cwichel/CCTVal_Steppers/Design documents/Pololu_Drivers.xlsx

 | AMIS-30543 page (https://www.pololu.com/product/2970/) | A4988 page (https://www.pololu.com/product/2980/) | A4988, Black Edition page (https://www.pololu.com/product/2976/) | DRV8880 page (https://www.pololu.com/product/2971/) | DRV8834 page (https://www.pololu.com/product/2134/) | DRV8824 page (https://www.pololu.com/product/2131/) | DRV8825 page (https://www.pololu.com/product/2977/)
Modelo | AMIS-30543 | A4988 | A4988, Black Edition | DRV8880 | DRV8834, Low-Voltage | DRV8824, Low-Current | DRV8825, High-Current
Imagen referencial
Minimum operating voltage (VM, VMOT) [V] | 6 | 8 | 8 | 2017-05-06 | 2017-05-02 | 2017-02-08 | 2017-02-08
Maximum operating voltage (VM, VMOT) [V] | 30 | 35 | 35 | 45 | 2017-08-10 | 45 | 45
Minimum logic voltage (VDD) [V] | 2017-05-02 | 3 | 3 | 2017-08-01 | 2017-05-02 | 2017-05-02 | 2017-05-02
Maximum logic voltage (VDD) [V] | 2017-05-05 | 2017-05-05 | 2017-05-05 | 2017-03-05 | 2017-05-05 | 5.25 | 5.25
Continuous current per phase [A] | 2017-08-01 | 1 | 2017-02-01 | 1 | 2017-05-01 | 0.75 | 2017-05-01
Maximum current per phase[A] with cooling | 3 | 2 | 2 | 2017-06-01 | 2 | 2017-02-01 | 2017-02-02
Microstep resolutions | full 1/2 1/4 1/8 1/16 1/32 1/64 1/128 | full 1/2 1/4 1/8 1/16 - - - | full 1/2 1/4 1/8 1/16 - - - | full 1/2, 1/2 non-circular 1/4 1/8 1/16 - - - | full 1/2 1/4 1/8 1/16 1/32 - - | full 1/2 1/4 1/8 1/16 1/32 - - | full 1/2 1/4 1/8 1/16 1/32 - -
 | limited current for VMOT<5V |  |  | It does not take external VDD supply | It does not take external VDD supply | It does not take external VDD supply | It does not take external VDD supply
