cwichel/CCTVal_Steppers/Design documents/Comm_Model.png

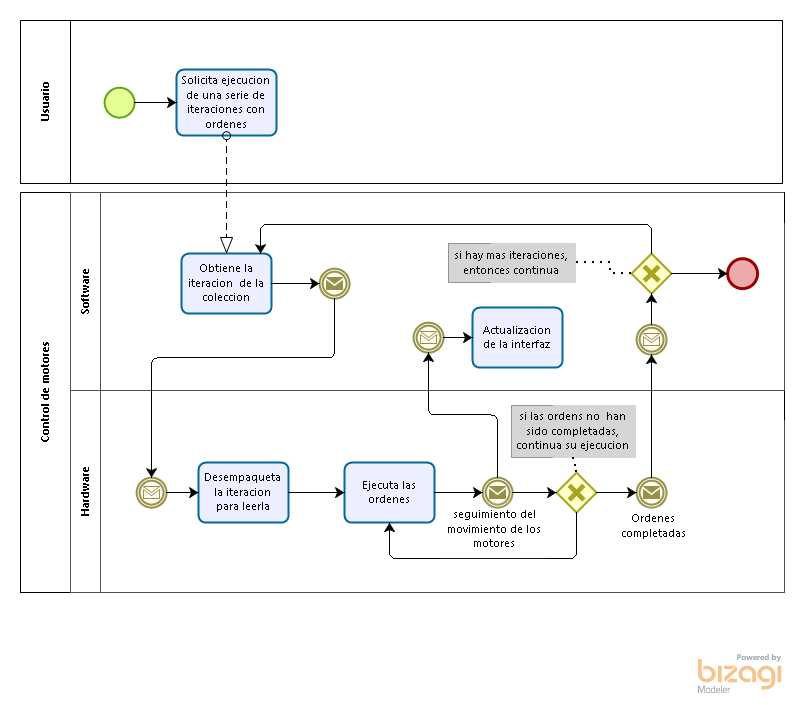
Design documents/Comm_Model.png
