cwichel/CCTVal_Steppers/Design documents/GUI.png

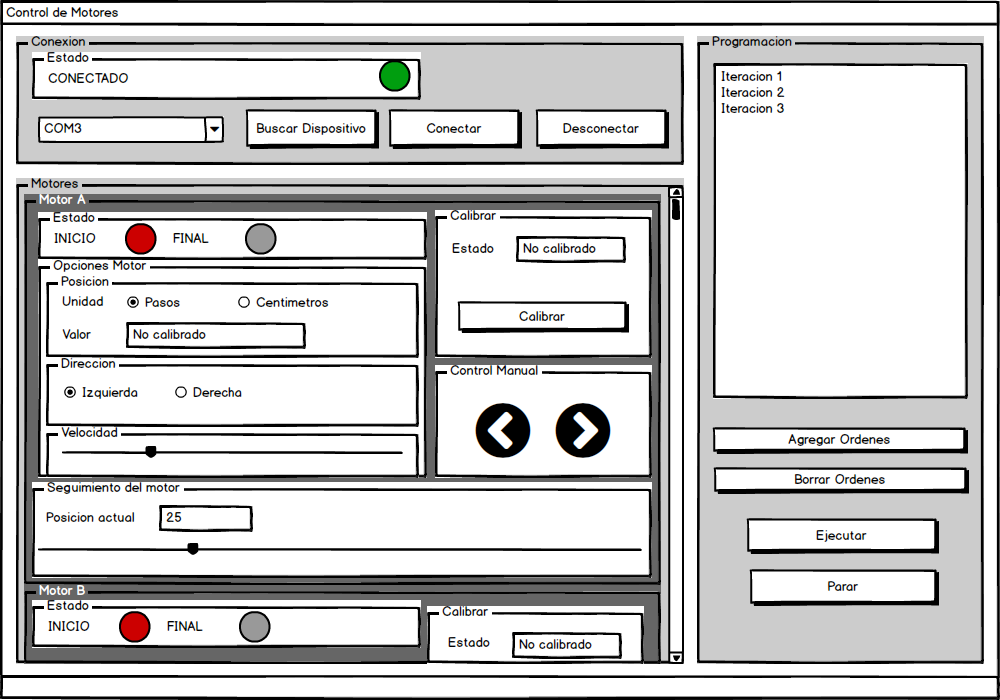
Design documents/GUI.png
