cwichel/CCTVal_Steppers/BOM/Steppers V2_0/BOM_Aliexpress_CCTVAL.csv

//Quantity | Company | Product | Page
35 | Tenstar Store | Arduino DUE R3 | https://goo.gl/kFpVzn
1 | Awesome Home Appliance Store | Desatornillador electrónica (pequeña) | https://goo.gl/UByTF8
1 | Awesome Home Appliance Store | Desatornillador de presición | https://goo.gl/uQCTkJ
1 | Awesome Home Appliance Store | Desatornillador multipropósito | https://goo.gl/f14CaZ
1 | Shenzen Tool Top Store | Kit cableado de redes | https://goo.gl/8skEQ2
1 | Shenzhen electronic tools | Estación de soldado (china+with kit E) | https://goo.gl/YdAr94
1 | Cleqee store | Generador de señales | https://goo.gl/MJtyGm
1 | Cleqee store | Osciloscopio | https://goo.gl/vScLHC
2 | China Inverter Factory | Fuente DC ajustable | https://goo.gl/KiWFQX
