cwichel/CCTVal_Steppers/Design documents/Comm_Protocols.xlsx

Sheet: Comandos
Comandos PC → Arduino |  |  |  |  |  | Comandos Arduino → PC
Codigo |  |  |  |  |  | Codigo
Int | Byte | Ascii | Sigla | Descripción | Modo de uso | Int | Byte | Ascii | Sigla | Descripción | Modo de uso
Inicio y final de los códigos
60 | 3C | < | Start | Inicio de comando | Start Comando <parametros> End Exe | 70 | 46 | F | Sok | Start Final | Sok Comando <parametros> Fok Nxt
61 | 3D | = | End | Fin de comando |  | 71 | 47 | G | Fok | Start End
62 | 3E | > | Exe | Ejecutar comandos |  | 72 | 48 | H | Nxt | Ok to send next
Asociados a movimiento
80 | 50 | P | M | Movimiento libre | Start M <motorx1><dir><vel> End | 90 | 5A | Z | Fm | Movement finished, tells to software the actual position of the motors | Sok Fm <motorx1><#pos>… Fok
81 | 51 | Q | MR | Movimiento rápido | Start MR <#motor><motorx1><#pos><#vel>… End
82 | 52 | R | ML | Movimiento lineal | Start ML <#motor><motorx1><#pos>….<#vel> End
Asociados a configuración
100 | 64 | d | Cal | Calibración | Start Cal <#motor><motorx1>… End | 110 | 6E | n | Fcal | Calibration result msg | Sok Fcal <motorx1><#totalsteps>… Fok
101 | 65 | e | Set | Setea PPR | Start M <motorx1><dir><vel> End | 111 | 6F | o | ESUon | Motor llego a FC1 | Sok ESUon <motorx1> Fok
 |  |  |  |  |  | 112 | 70 | p | ESUoff | Motor salio de FC1 | Sok ESUoff <motorx1> Fok
 |  |  |  |  |  | 113 | 71 | q | ESLon | Motor llego a FC2 | Sok ESLon <motorx1> Fok
 |  |  |  |  |  | 114 | 72 | r | ESLoff | Motor salio de FC2 | Sok ESLoff <motorx1> Fok
Ejemplos

Sheet: Variables (para comandos)
Variable | tipo | bytes
Selección de motor | uint | 1
Dirección de giro | uint | 1
Indicación de velocidad (en rpm) | uint | 2
Cantidad de pasos en tramo (calibración) | uint | 4
Indicación de posición (en pasos) | uint | 4

Sheet: Otros
Var | Cantidad |  | Descripción |  | [us] | [Hz]
TInt | 2.5e-05 | [s] | Período de interrupción |  | 25 | 40000
Kchk | 0.03 | [s] | Periodo para check key |  | 30000 |  | 1200
PPV | 200 | [#] | Pasos por vuelta |  | [ipc] |  |  | [comprobacion]
V | 180 | [rpm] | Velocidad | -> | 33 |  |  | 181.8181818
 |  |  |  |  | 100 | 0.0025 | 400
