cwichel/CCTVal_Steppers/BOM/Steppers V2_0/BOM_Aliexpress.png

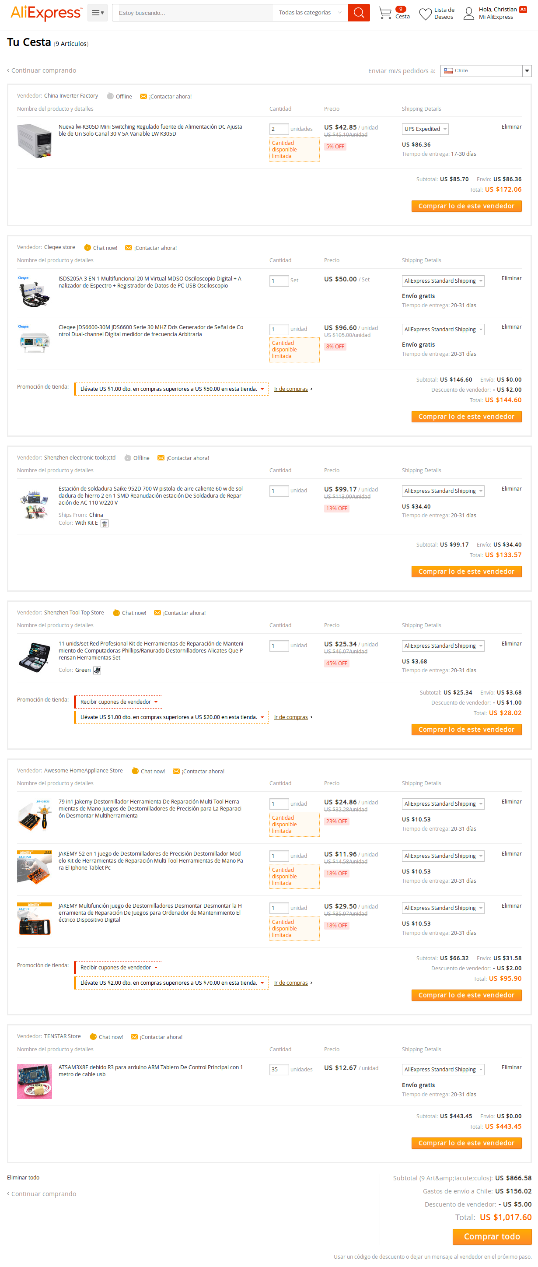
BOM/Steppers V2_0/BOM_Aliexpress.png
