cwichel/CCTVal_Steppers/BOM/Steppers V2_0/BOM_Digikey.png

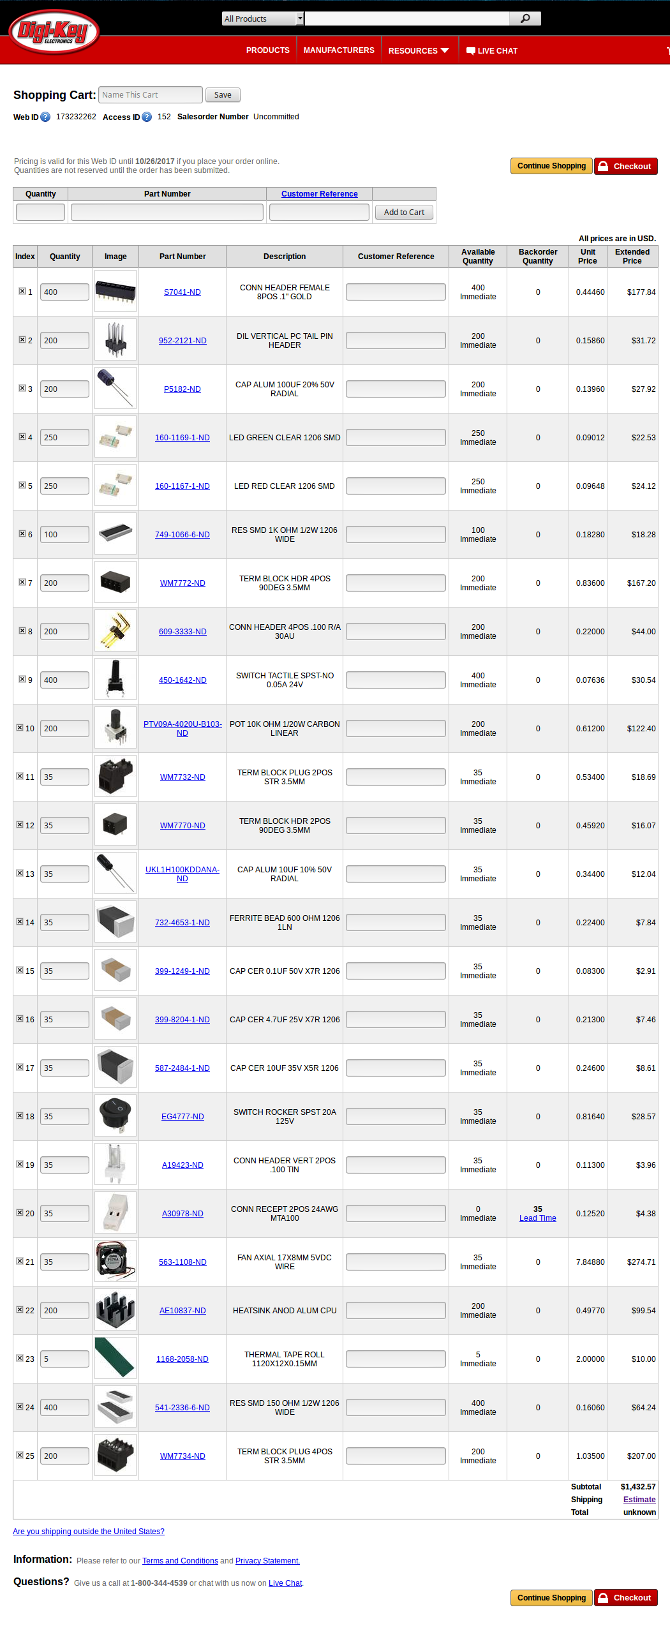
BOM/Steppers V2_0/BOM_Digikey.png
