cwichel/CCTVal_Steppers/BOM/Steppers V2_0/BOM_Mouser.png

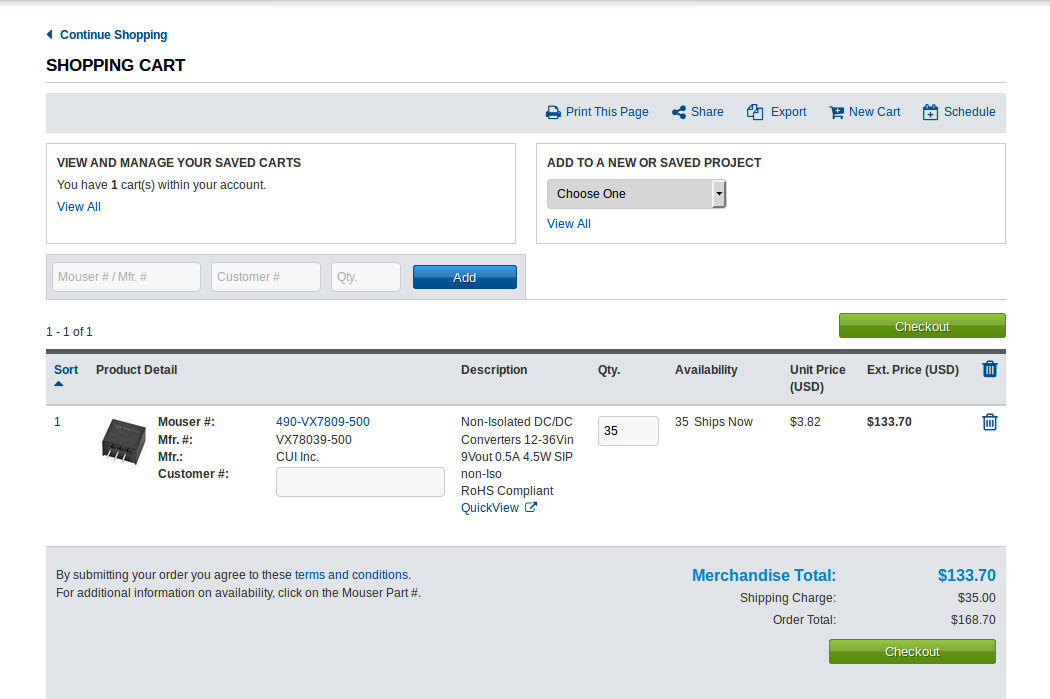
BOM/Steppers V2_0/BOM_Mouser.png
