cwichel/CCTVal_Steppers/BOM/Steppers V2_0/BOM_Pololu.png

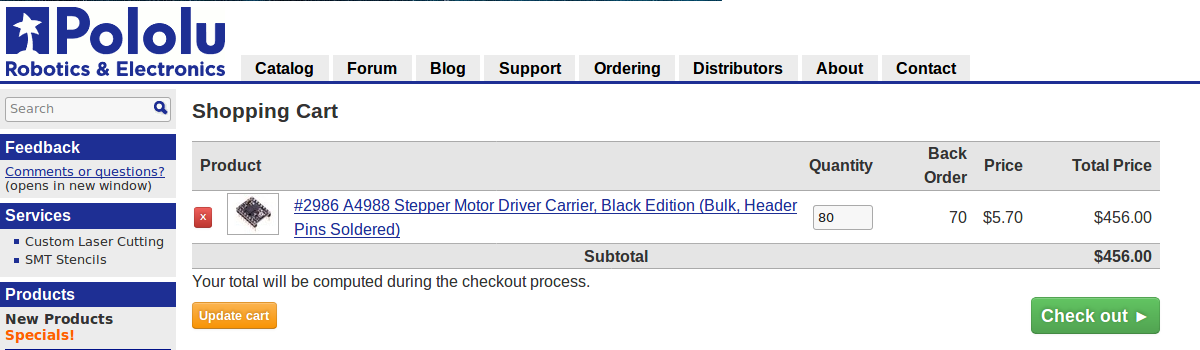
BOM/Steppers V2_0/BOM_Pololu.png
