cwichel/CCTVal_Steppers/BOM/Steppers V2_0/BOM_Seeed.png

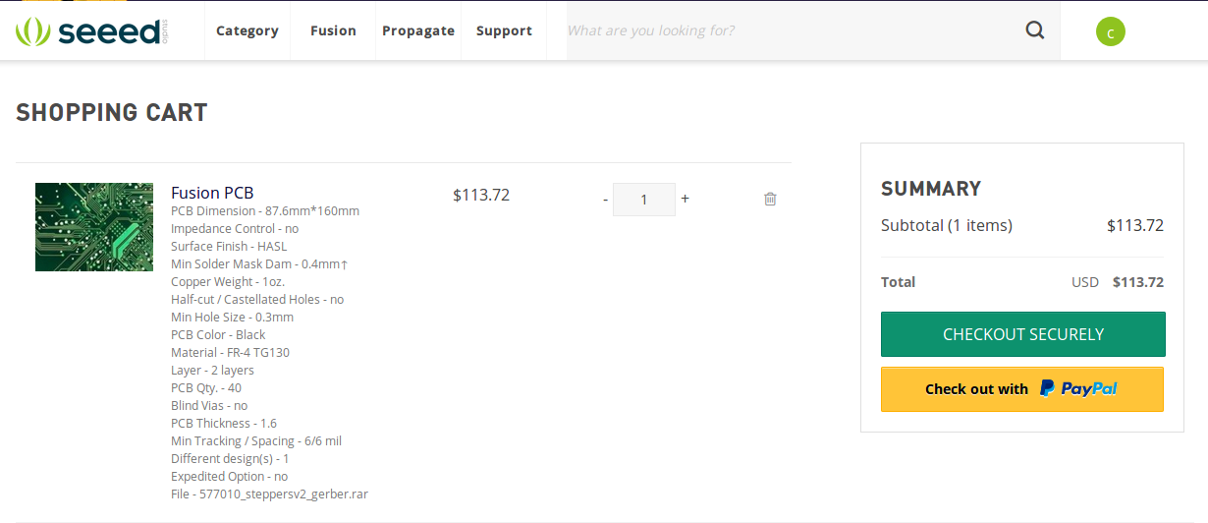
BOM/Steppers V2_0/BOM_Seeed.png
