cwichel/CCTVal_Steppers/CAD/Stepper_1_0/Stepper_1_0.brd

## EAGLE design CAD/Stepper_1_0/Stepper_1_0.brd (2017-09-14)

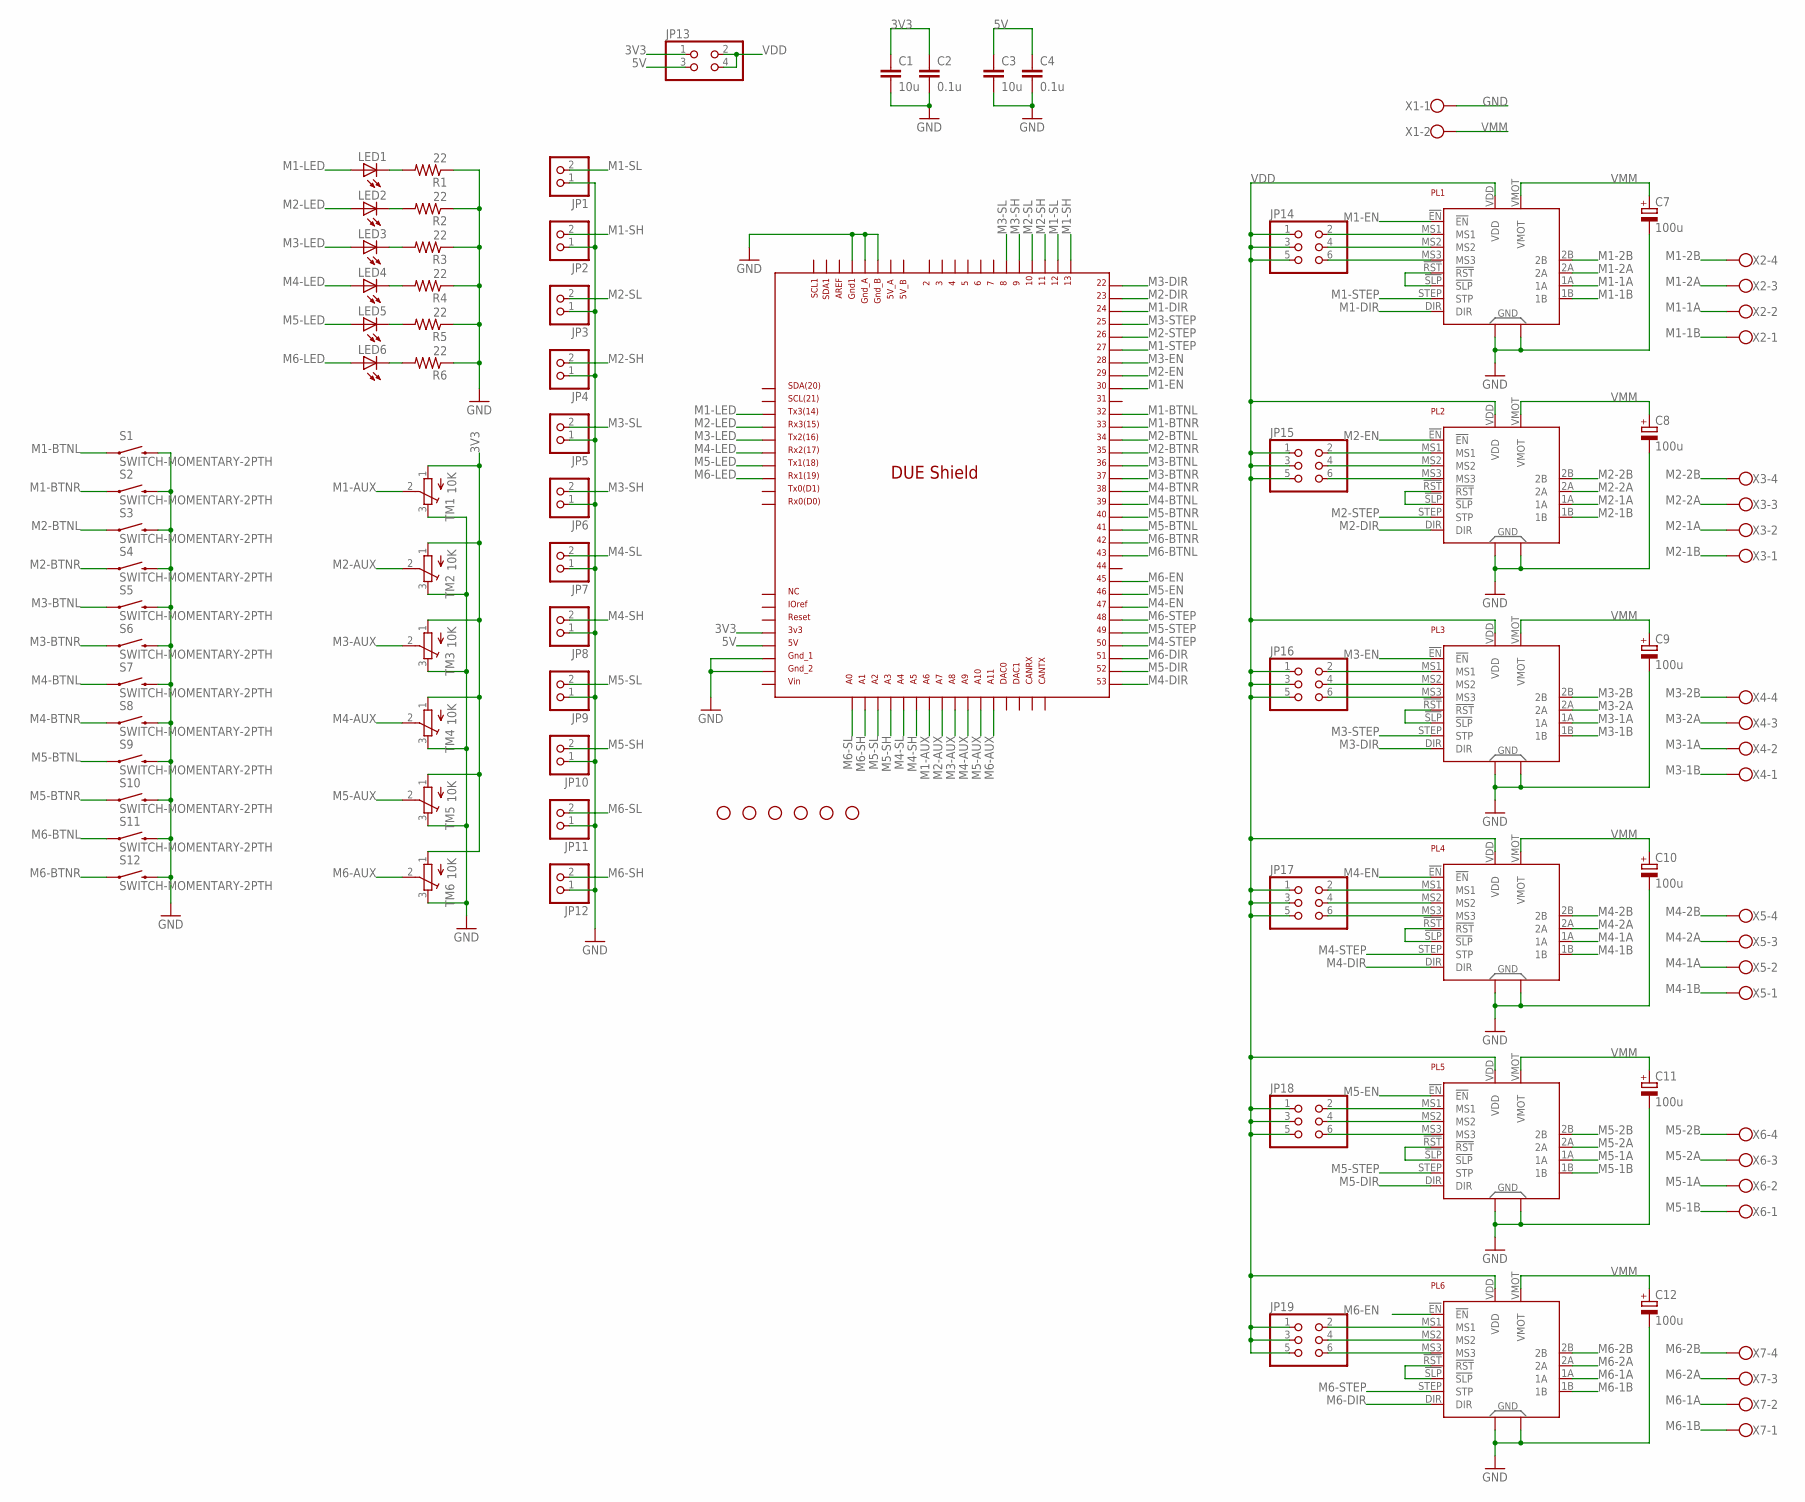
[picture p8: schematic Stepper_1_0.sch]

Parts:
C1, C3: 10u; 1206
C2, C4: 0.1u; 1206
C7, C8, C9, C10, C11, C12: 100u; ETR2
H1, H2, H3, H4, H5, H6: STAND-OFF
JP1, JP2, JP3, JP4, JP5, JP6, JP7, JP8, JP9, JP10, JP11, JP12: PINHD-1X2; 1X02
JP13: PINHD-2X2; 2X02
JP14, JP15, JP16, JP17, JP18, JP19: PINHD-2X3; 2X03
LED1, LED2, LED3, LED4, LED5, LED6: LEDSMT1206; 1206
PL1, PL2, PL3, PL4, PL5, PL6: A4988X; MD09X
R1, R2, R3, R4, R5, R6: 22; 1206
S1, S2, S3, S4, S5, S6, S7, S8, S9, S10, S11, S12: SWITCH-MOMENTARY-2PTH; TACTILE-PTH
SH1: DUE(NOSPI)
TM1, TM2, TM3, TM4, TM5, TM6: 10K; TC33X
X1: W237-102
X2, X3, X4, X5, X6, X7: W237-4

Connections:
3V3: C1.1, C2.1, JP13.1, SH1.3V3, TM1.1 (A), TM2.1 (A), TM3.1 (A), TM4.1 (A), TM5.1 (A), TM6.1 (A)
5V: C3.1, C4.1, JP13.3, SH1.5V
GND: C1.2, C2.2, C3.2, C4.2, C7.-, C8.-, C9.-, C10.-, C11.-, C12.-, JP1.1, JP2.1, JP3.1, JP4.1, JP5.1, JP6.1, JP7.1, JP8.1, JP9.1, JP10.1, JP11.1, JP12.1, PL1.GND1, PL1.GND2, PL2.GND1, PL2.GND2, PL3.GND1, PL3.GND2, PL4.GND1, PL4.GND2, PL5.GND1, PL5.GND2, PL6.GND1, PL6.GND2, R1.1, R2.1, R3.1, R4.1, R5.1, R6.1, S1.3 (2), S2.3 (2), S3.3 (2), S4.3 (2), S5.3 (2), S6.3 (2), S7.3 (2), S8.3 (2), S9.3 (2), S10.3 (2), S11.3 (2), S12.3 (2), SH1.GND1, SH1.GND_1, SH1.GND_2, SH1.GND_A, SH1.GND_B, TM1.3 (E), TM2.3 (E), TM3.3 (E), TM4.3 (E), TM5.3 (E), TM6.3 (E), X1.1
M1-1A: PL1.1A, X2.2
M1-1B: PL1.1B, X2.1
M1-2A: PL1.2A, X2.3
M1-2B: PL1.2B, X2.4
M1-AUX: SH1.A6, TM1.2 (S)
M1-BTNL: S1.1, SH1.32
M1-BTNR: S2.1, SH1.33
M1-DIR: PL1.DIR, SH1.24
M1-EN: PL1.!EN, SH1.30
M1-LED: LED1.A, SH1.TX3
M1-SH: JP2.2, SH1.13
M1-SL: JP1.2, SH1.12
M1-STEP: PL1.STEP (STP), SH1.27
M2-1A: PL2.1A, X3.2
M2-1B: PL2.1B, X3.1
M2-2A: PL2.2A, X3.3
M2-2B: PL2.2B, X3.4
M2-AUX: SH1.A7, TM2.2 (S)
M2-BTNL: S3.1, SH1.34
M2-BTNR: S4.1, SH1.35
M2-DIR: PL2.DIR, SH1.23
M2-EN: PL2.!EN, SH1.29
M2-LED: LED2.A, SH1.RX3
M2-SH: JP4.2, SH1.11
M2-SL: JP3.2, SH1.10
M2-STEP: PL2.STEP (STP), SH1.26
M3-1A: PL3.1A, X4.2
M3-1B: PL3.1B, X4.1
M3-2A: PL3.2A, X4.3
M3-2B: PL3.2B, X4.4
M3-AUX: SH1.A8, TM3.2 (S)
M3-BTNL: S5.1, SH1.36
M3-BTNR: S6.1, SH1.37
M3-DIR: PL3.DIR, SH1.22
M3-EN: PL3.!EN, SH1.28
M3-LED: LED3.A, SH1.TX2
M3-SH: JP6.2, SH1.9
M3-SL: JP5.2, SH1.8
M3-STEP: PL3.STEP (STP), SH1.25
M4-1A: PL4.1A, X5.2
M4-1B: PL4.1B, X5.1
M4-2A: PL4.2A, X5.3
M4-2B: PL4.2B, X5.4
M4-AUX: SH1.A9, TM4.2 (S)
M4-BTNL: S7.1, SH1.39
M4-BTNR: S8.1, SH1.38
M4-DIR: PL4.DIR, SH1.53
M4-EN: PL4.!EN, SH1.47
M4-LED: LED4.A, SH1.RX2
M4-SH: JP8.2, SH1.A5
M4-SL: JP7.2, SH1.A4
M4-STEP: PL4.STEP (STP), SH1.50
M5-1A: PL5.1A, X6.2
M5-1B: PL5.1B, X6.1
M5-2A: PL5.2A, X6.3
M5-2B: PL5.2B, X6.4
M5-AUX: SH1.A10, TM5.2 (S)
M5-BTNL: S9.1, SH1.41
M5-BTNR: S10.1, SH1.40
M5-DIR: PL5.DIR, SH1.52
M5-EN: PL5.!EN, SH1.46
M5-LED: LED5.A, SH1.TX1
M5-SH: JP10.2, SH1.A3
M5-SL: JP9.2, SH1.A2
M5-STEP: PL5.STEP (STP), SH1.49
M6-1A: PL6.1A, X7.2
M6-1B: PL6.1B, X7.1
M6-2A: PL6.2A, X7.3
M6-2B: PL6.2B, X7.4
M6-AUX: SH1.A11, TM6.2 (S)
M6-BTNL: S11.1, SH1.43
M6-BTNR: S12.1, SH1.42
M6-DIR: PL6.DIR, SH1.51
M6-EN: PL6.!EN, SH1.45
M6-LED: LED6.A, SH1.RX1
M6-SH: JP12.2, SH1.A1
M6-SL: JP11.2, SH1.A0
M6-STEP: PL6.STEP (STP), SH1.48
unnamed: JP15.2, PL2.MS1
unnamed: PL1.!RST, PL1.!SLP
unnamed: JP15.6, PL2.MS3
unnamed: JP15.4, PL2.MS2
unnamed: PL2.!RST, PL2.!SLP
unnamed: PL3.!RST, PL3.!SLP
unnamed: JP16.6, PL3.MS3
unnamed: JP16.4, PL3.MS2
unnamed: PL4.!RST, PL4.!SLP
unnamed: JP14.6, PL1.MS3
unnamed: JP14.4, PL1.MS2
unnamed: JP14.2, PL1.MS1
unnamed: JP16.2, PL3.MS1
unnamed: JP17.6, PL4.MS3
unnamed: JP17.4, PL4.MS2
unnamed: JP17.2, PL4.MS1
unnamed: JP18.6, PL5.MS3
unnamed: JP18.4, PL5.MS2
unnamed: JP18.2, PL5.MS1
unnamed: JP19.6, PL6.MS3
unnamed: JP19.4, PL6.MS2
unnamed: JP19.2, PL6.MS1
unnamed: PL5.!RST, PL5.!SLP
unnamed: PL6.!RST, PL6.!SLP
unnamed: LED1.C, R1.2
unnamed: LED2.C, R2.2
unnamed: LED3.C, R3.2
unnamed: LED4.C, R4.2
unnamed: LED5.C, R5.2
unnamed: LED6.C, R6.2
VDD: JP13.2, JP13.4, JP14.1, JP14.3, JP14.5, JP15.1, JP15.3, JP15.5, JP16.1, JP16.3, JP16.5, JP17.1, JP17.3, JP17.5, JP18.1, JP18.3, JP18.5, JP19.1, JP19.3, JP19.5, PL1.VDD, PL2.VDD, PL3.VDD, PL4.VDD, PL5.VDD, PL6.VDD
VMM: C7.+, C8.+, C9.+, C10.+, C11.+, C12.+, PL1.VMOT, PL2.VMOT, PL3.VMOT, PL4.VMOT, PL5.VMOT, PL6.VMOT, X1.2

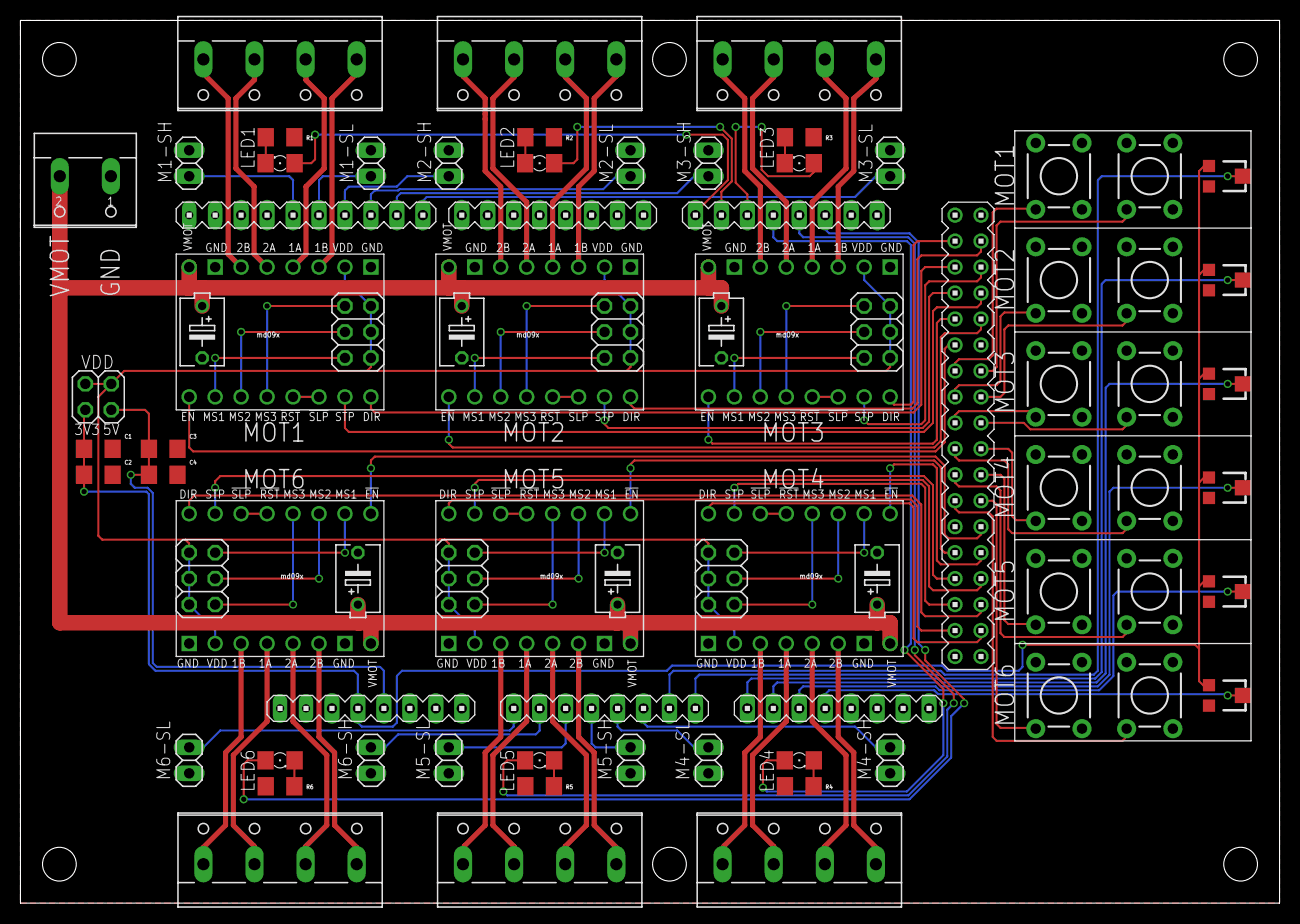
[picture p9: board Stepper_1_0.brd from above]

Board: 2 copper layers, 123.2 x 86.4 mm, 79 parts (0 on the bottom side), 113 nets.
