cwichel/CCTVal_Steppers/CAD/Stepper_2_0/Stepper_2_0.brd

## EAGLE design CAD/Stepper_2_0/Stepper_2_0.brd (2017-09-22)

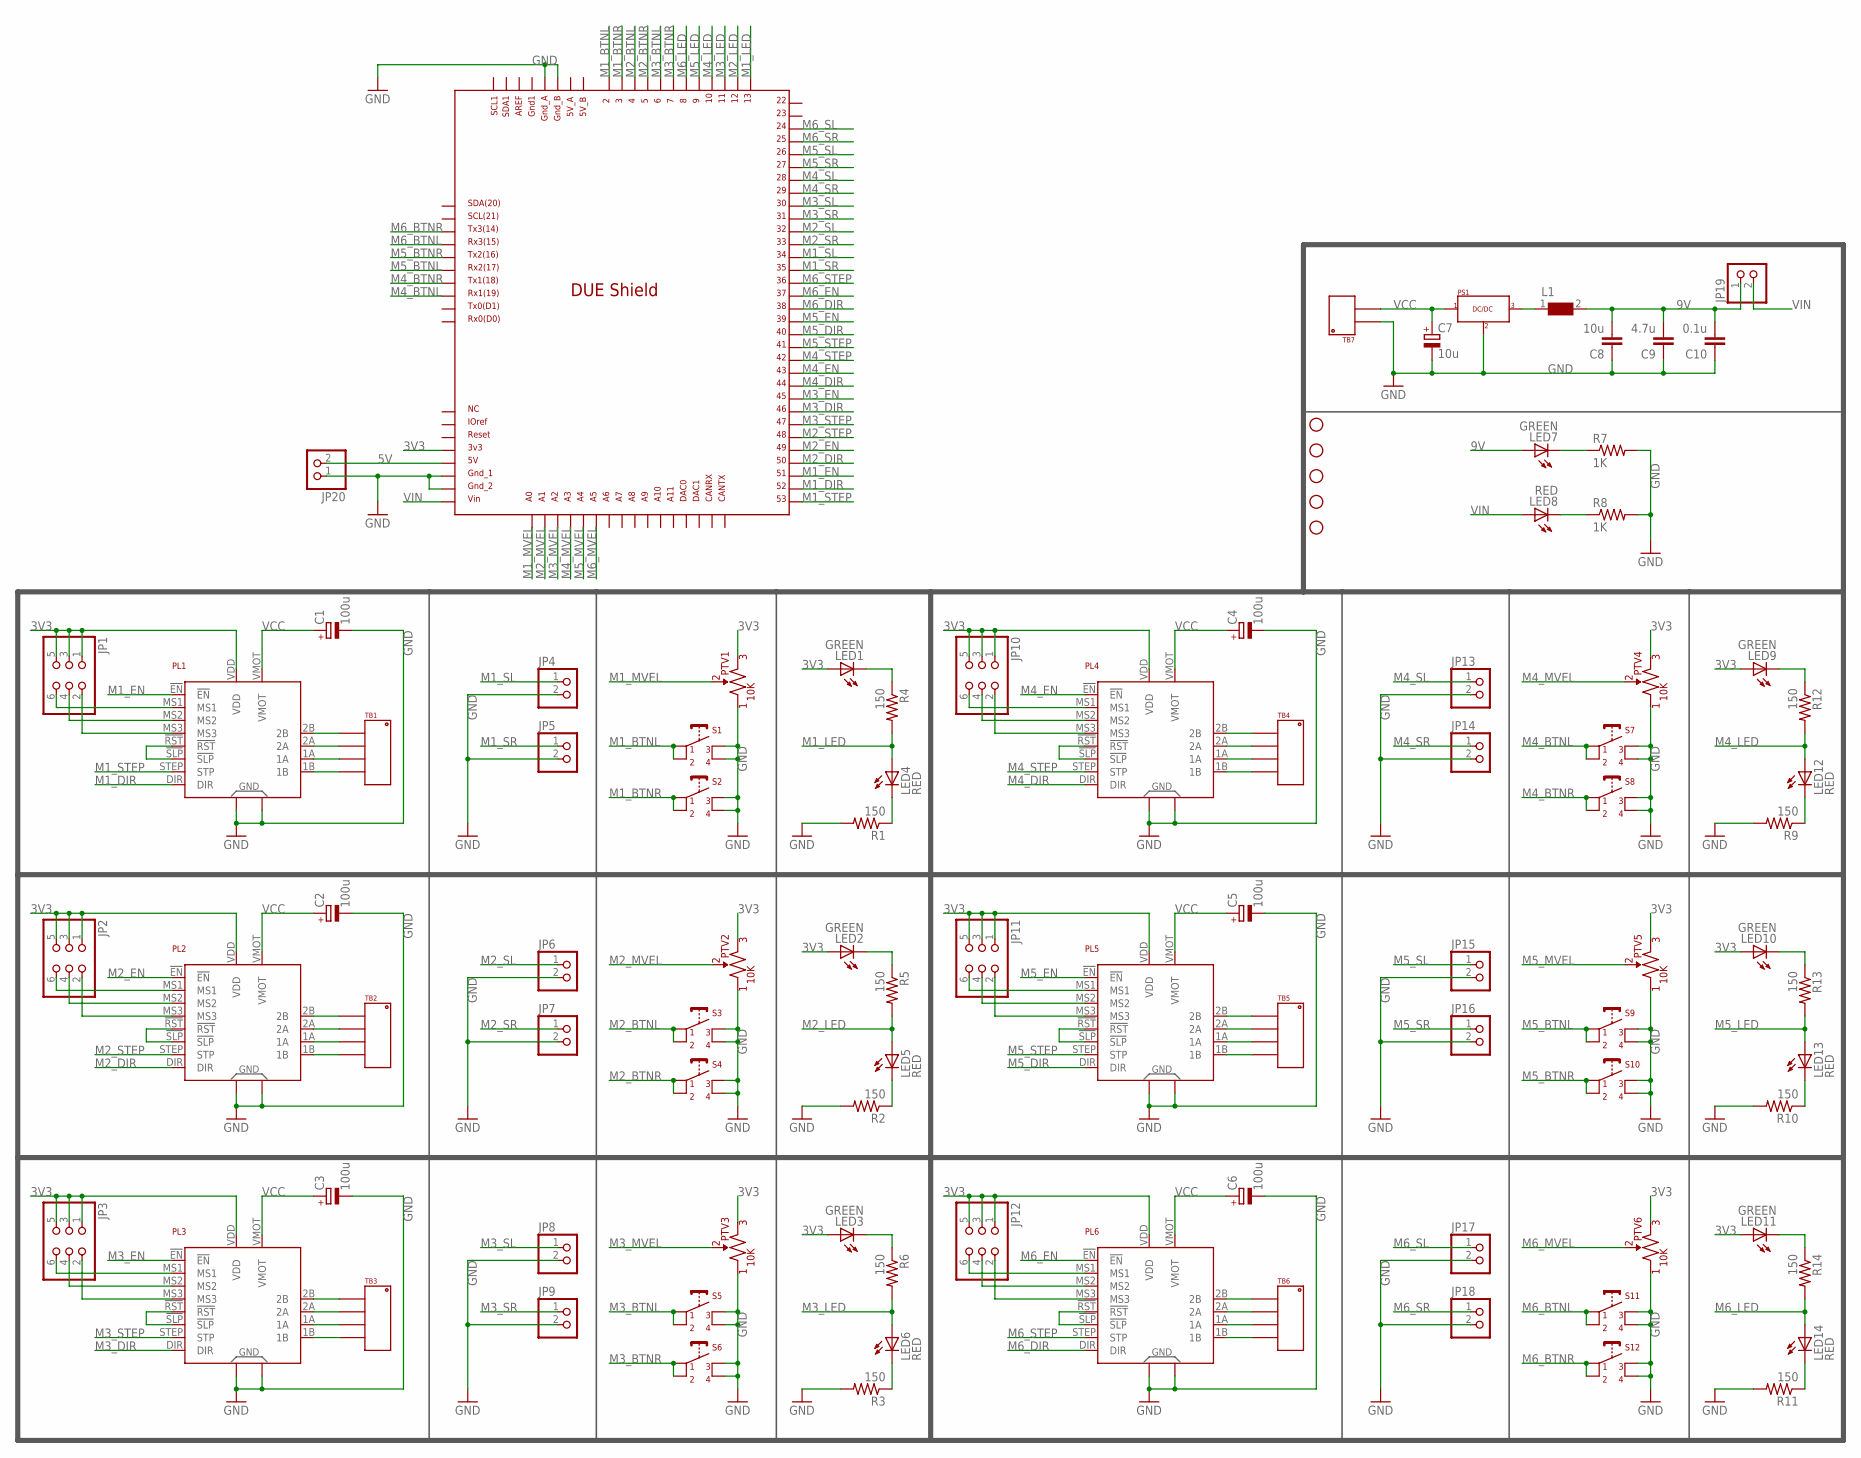
[picture p10: schematic Stepper_2_0.sch]

Parts:
C1, C2, C3, C4, C5, C6: 100u; ETR2
C7: 10u; E2-4
C8: 10u; 1206
C9: 4.7u; 1206
C10: 0.1u; 1206
DUE1: DUE(NOSPI)
H1, H2, H3, H4, H5: STAND-OFF
JP1, JP2, JP3, JP10, JP11, JP12: PINHD-2X3; 2X03
JP4, JP5, JP6, JP7, JP8, JP9, JP13, JP14, JP15, JP16, JP17, JP18, JP19, JP20: PINHD-1X2; 1X02
L1: WE-CBF-742792118_1206; 1206
LED1, LED2, LED3, LED7, LED9, LED10, LED11: GREEN; 1206
LED4, LED5, LED6, LED8, LED12, LED13, LED14: RED; 1206
PL1, PL2, PL3, PL4, PL5, PL6: A4988X; MD09X
PS1: VX78-500
PTV1, PTV2, PTV3, PTV4, PTV5, PTV6: 10K; PTV09A-4
R1, R2, R3, R4, R5, R6, R9, R10, R11, R12, R13, R14: 150; 1206
R7, R8: 1K; 1206
S1, S2, S3, S4, S5, S6, S7, S8, S9, S10, S11, S12: BTN_SPST_6MM
TB1, TB2, TB3, TB4, TB5, TB6: TB_HEAD_3.5MM_01X04
TB7: TB_HEAD_3.5MM_01X02

Connections:
3V3: DUE1.3V3, JP1.1, JP1.3, JP1.5, JP2.1, JP2.3, JP2.5, JP3.1, JP3.3, JP3.5, JP10.1, JP10.3, JP10.5, JP11.1, JP11.3, JP11.5, JP12.1, JP12.3, JP12.5, LED1.A, LED2.A, LED3.A, LED9.A, LED10.A, LED11.A, PL1.VDD, PL2.VDD, PL3.VDD, PL4.VDD, PL5.VDD, PL6.VDD, PTV1.P$3 (3), PTV2.P$3 (3), PTV3.P$3 (3), PTV4.P$3 (3), PTV5.P$3 (3), PTV6.P$3 (3)
5V: DUE1.5V, JP20.2
9V: C8.2, C9.2, C10.2, JP19.1, L1.2, LED7.A
GND: C1.-, C2.-, C3.-, C4.-, C5.-, C6.-, C7.-, C8.1, C9.1, C10.1, DUE1.GND_1, DUE1.GND_2, DUE1.GND_A, DUE1.GND_B, JP4.2, JP5.2, JP6.2, JP7.2, JP8.2, JP9.2, JP13.2, JP14.2, JP15.2, JP16.2, JP17.2, JP18.2, JP20.1, PL1.GND1, PL1.GND2, PL2.GND1, PL2.GND2, PL3.GND1, PL3.GND2, PL4.GND1, PL4.GND2, PL5.GND1, PL5.GND2, PL6.GND1, PL6.GND2, PS1.P$3, PTV1.P$1 (1), PTV2.P$1 (1), PTV3.P$1 (1), PTV4.P$1 (1), PTV5.P$1 (1), PTV6.P$1 (1), R1.2, R2.2, R3.2, R7.2, R8.2, R9.2, R10.2, R11.2, S1.P$3 (3), S1.P$4 (4), S2.P$3 (3), S2.P$4 (4), S3.P$3 (3), S3.P$4 (4), S4.P$3 (3), S4.P$4 (4), S5.P$3 (3), S5.P$4 (4), S6.P$3 (3), S6.P$4 (4), S7.P$3 (3), S7.P$4 (4), S8.P$3 (3), S8.P$4 (4), S9.P$3 (3), S9.P$4 (4), S10.P$3 (3), S10.P$4 (4), S11.P$3 (3), S11.P$4 (4), S12.P$3 (3), S12.P$4 (4), TB7.P$1
M1_BTNL: DUE1.2, S1.P$1 (1), S1.P$2 (2)
M1_BTNR: DUE1.3, S2.P$1 (1), S2.P$2 (2)
M1_DIR: DUE1.52, PL1.DIR
M1_EN: DUE1.51, PL1.!EN
M1_LED: DUE1.13, LED4.A, R4.2
M1_MVEL: DUE1.A0, PTV1.P$2 (2)
M1_SL: DUE1.34, JP4.1
M1_SR: DUE1.35, JP5.1
M1_STEP: DUE1.53, PL1.STEP (STP)
M2_BTNL: DUE1.4, S3.P$1 (1), S3.P$2 (2)
M2_BTNR: DUE1.5, S4.P$1 (1), S4.P$2 (2)
M2_DIR: DUE1.50, PL2.DIR
M2_EN: DUE1.49, PL2.!EN
M2_LED: DUE1.12, LED5.A, R5.2
M2_MVEL: DUE1.A1, PTV2.P$2 (2)
M2_SL: DUE1.32, JP6.1
M2_SR: DUE1.33, JP7.1
M2_STEP: DUE1.48, PL2.STEP (STP)
M3_BTNL: DUE1.6, S5.P$1 (1), S5.P$2 (2)
M3_BTNR: DUE1.7, S6.P$1 (1), S6.P$2 (2)
M3_DIR: DUE1.46, PL3.DIR
M3_EN: DUE1.45, PL3.!EN
M3_LED: DUE1.11, LED6.A, R6.2
M3_MVEL: DUE1.A2, PTV3.P$2 (2)
M3_SL: DUE1.30, JP8.1
M3_SR: DUE1.31, JP9.1
M3_STEP: DUE1.47, PL3.STEP (STP)
M4_BTNL: DUE1.RX1, S7.P$1 (1), S7.P$2 (2)
M4_BTNR: DUE1.TX1, S8.P$1 (1), S8.P$2 (2)
M4_DIR: DUE1.44, PL4.DIR
M4_EN: DUE1.43, PL4.!EN
M4_LED: DUE1.10, LED12.A, R12.2
M4_MVEL: DUE1.A3, PTV4.P$2 (2)
M4_SL: DUE1.28, JP13.1
M4_SR: DUE1.29, JP14.1
M4_STEP: DUE1.42, PL4.STEP (STP)
M5_BTNL: DUE1.RX2, S9.P$1 (1), S9.P$2 (2)
M5_BTNR: DUE1.TX2, S10.P$1 (1), S10.P$2 (2)
M5_DIR: DUE1.40, PL5.DIR
M5_EN: DUE1.39, PL5.!EN
M5_LED: DUE1.9, LED13.A, R13.2
M5_MVEL: DUE1.A4, PTV5.P$2 (2)
M5_SL: DUE1.26, JP15.1
M5_SR: DUE1.27, JP16.1
M5_STEP: DUE1.41, PL5.STEP (STP)
M6_BTNL: DUE1.RX3, S11.P$1 (1), S11.P$2 (2)
M6_BTNR: DUE1.TX3, S12.P$1 (1), S12.P$2 (2)
M6_DIR: DUE1.38, PL6.DIR
M6_EN: DUE1.37, PL6.!EN
M6_LED: DUE1.8, LED14.A, R14.2
M6_MVEL: DUE1.A5, PTV6.P$2 (2)
M6_SL: DUE1.24, JP17.1
M6_SR: DUE1.25, JP18.1
M6_STEP: DUE1.36, PL6.STEP (STP)
unnamed: PL2.1B, TB2.P$4
unnamed: PL2.1A, TB2.P$3
unnamed: PL2.2A, TB2.P$2
unnamed: PL2.2B, TB2.P$1
unnamed: PL2.!RST, PL2.!SLP
unnamed: JP2.2, PL2.MS3
unnamed: JP2.4, PL2.MS2
unnamed: JP2.6, PL2.MS1
unnamed: LED4.C, R1.1
unnamed: LED5.C, R2.1
unnamed: LED1.C, R4.1
unnamed: LED2.C, R5.1
unnamed: PL3.1B, TB3.P$4
unnamed: PL3.1A, TB3.P$3
unnamed: PL3.2A, TB3.P$2
unnamed: PL3.2B, TB3.P$1
unnamed: PL3.!RST, PL3.!SLP
unnamed: JP3.2, PL3.MS3
unnamed: JP3.4, PL3.MS2
unnamed: JP3.6, PL3.MS1
unnamed: LED6.C, R3.1
unnamed: LED3.C, R6.1
unnamed: PL4.1B, TB4.P$4
unnamed: PL4.1A, TB4.P$3
unnamed: PL4.2A, TB4.P$2
unnamed: PL4.2B, TB4.P$1
unnamed: PL4.!RST, PL4.!SLP
unnamed: JP10.2, PL4.MS3
unnamed: JP10.4, PL4.MS2
unnamed: JP10.6, PL4.MS1
unnamed: LED12.C, R9.1
unnamed: LED9.C, R12.1
unnamed: PL5.1B, TB5.P$4
unnamed: PL5.1A, TB5.P$3
unnamed: PL5.2A, TB5.P$2
unnamed: PL5.2B, TB5.P$1
unnamed: PL5.!RST, PL5.!SLP
unnamed: JP11.2, PL5.MS3
unnamed: JP11.4, PL5.MS2
unnamed: JP11.6, PL5.MS1
unnamed: LED13.C, R10.1
unnamed: LED10.C, R13.1
unnamed: PL6.1B, TB6.P$4
unnamed: PL6.1A, TB6.P$3
unnamed: PL6.2A, TB6.P$2
unnamed: PL6.2B, TB6.P$1
unnamed: PL6.!RST, PL6.!SLP
unnamed: JP12.6, PL6.MS1
unnamed: JP12.4, PL6.MS2
unnamed: JP12.2, PL6.MS3
unnamed: LED14.C, R11.1
unnamed: PL1.1B, TB1.P$4
unnamed: PL1.1A, TB1.P$3
unnamed: PL1.2A, TB1.P$2
unnamed: PL1.2B, TB1.P$1
unnamed: LED11.C, R14.1
unnamed: PL1.!RST, PL1.!SLP
unnamed: JP1.2, PL1.MS3
unnamed: JP1.4, PL1.MS2
unnamed: JP1.6, PL1.MS1
unnamed: L1.1, PS1.P$2
unnamed: LED7.C, R7.1
unnamed: LED8.C, R8.1
VCC: C1.+, C2.+, C3.+, C4.+, C5.+, C6.+, C7.+, PL1.VMOT, PL2.VMOT, PL3.VMOT, PL4.VMOT, PL5.VMOT, PL6.VMOT, PS1.P$1, TB7.P$2
VIN: DUE1.VIN, JP19.2, LED8.A

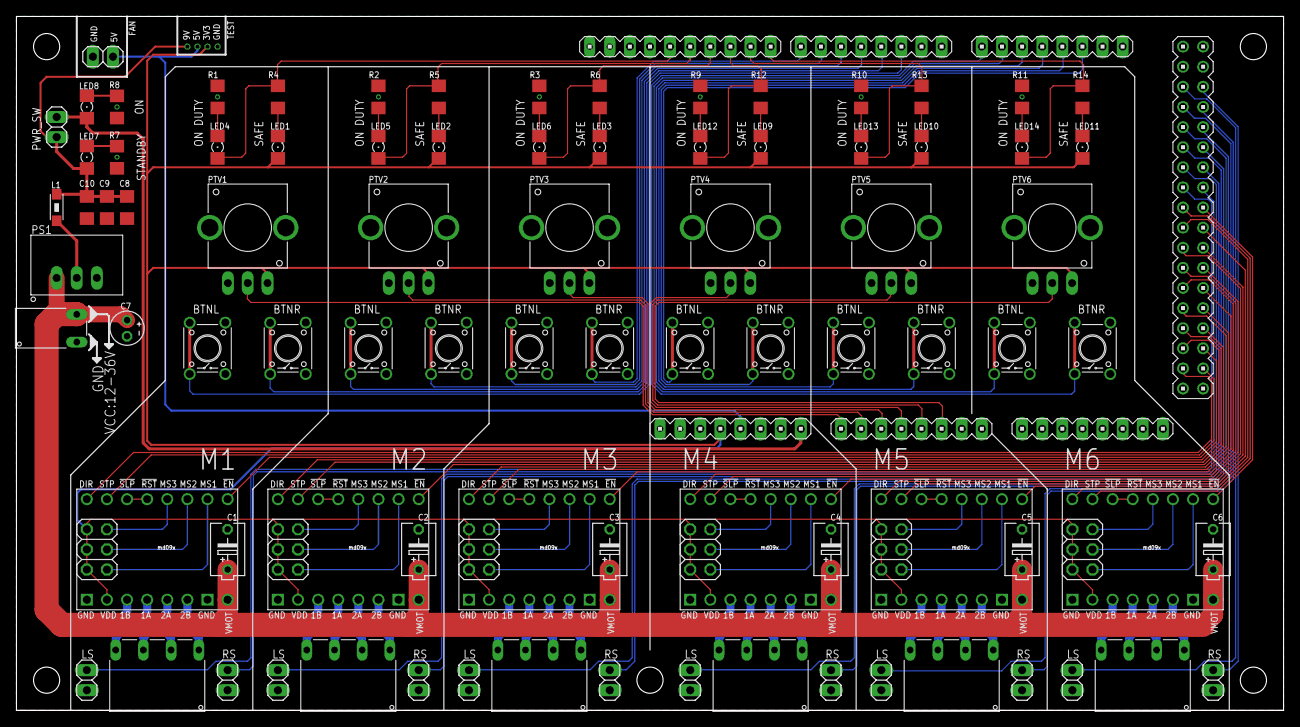
[picture p11: board Stepper_2_0.brd from above]

Board: 2 copper layers, 160.0 x 87.6 mm, 97 parts (0 on the bottom side), 123 nets.
