cwichel/CCTVal_Steppers/(commit log)

2017-09-13 Inicial
    Se agrega el trabajo actual al repositorio.
    [BOM_digikey_CCTVAL.csv, BOM_pololu_CCTVAL.csv, Comm_Protocols.xlsx, Pololu_Drivers.xlsx, Stepper_1_0.brd, Stepper_1_0.sch]
2017-09-14 Steppers:
    Se agregan nuevos componentes en la librería del proyecto, se comienza con el diseño esquemático de la versión 2
    [Stepper_1_0.brd, Stepper_2_0.sch]
2017-09-14 Steppers:
    Se comienza a agregar el potenciómetro a lalibreria del proyecto, se avanza con el esquemático dela V2
    [Stepper_2_0.sch]
2017-09-15 Steppers:
    Se mejora el modelo del potenciómetro en la libreria y se agrega l boton de 6mm, se avanza en el esquemático de la V2
    [Stepper_2_0.brd, Stepper_2_0.sch]
2017-09-17 Steppers:
    Se avanza en el diseño esquemático y de PCB
    [Stepper_2_0.sch]
2017-09-17 Steppers:
    Corrección de esquemático
    [Stepper_2_0.sch]
2017-09-17 Steppers:
    Avance en PCB final, asignación de pines DUE.
    [Stepper_2_0.brd, Stepper_2_0.sch]
2017-09-17 Steppers:
    Se finaliza el esquemático y PCB de forma funcional.
    [Stepper_2_0.brd, Stepper_2_0.sch]
2017-09-17 Steppers:
    Se añaden pads para testeo de voltajes y conexión de 5V para ventilador.
    [Stepper_2_0.brd, Stepper_2_0.sch]
2017-09-20 Steppers:
    Eagle proyect update
2017-09-22 Steppers:
    Se agregan las medidas de la placa para referencia.
    [Stepper_2_0.brd]
2017-09-22 Steppers:
    BOM y Gerber
    [BOM_Aliexpress_CCTVAL.csv, BOM_Mouser_CCTVAL.csv, BOM_digikey_CCTVAL.csv, BOM_pololu_CCTVAL.csv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]
2017-09-26 Steppers:
    Se actualiza el BOM de compras en aliexpress
    [BOM_Aliexpress_CCTVAL.csv]
2017-09-26 Summary:
    Crear listas de compra para revisión.
    [BOM_Aliexpress_CCTVAL.csv, BOM_Mouser_CCTVAL.csv, BOM_digikey_CCTVAL.csv]
2018-04-17 Update:
    - Nueva organización del proyecto
    - Inicio de modificaciones en el firmware
    [BOM_Aliexpress_CCTVAL.csv, BOM_Mouser_CCTVAL.csv, BOM_digikey_CCTVAL.csv, BOM_pololu_CCTVAL.csv, Comm_Protocols.xlsx, Pololu_Drivers.xlsx, Stepper_1_0.brd, Stepper_1_0.sch]
